Robert-Knutson/Treadmill/ReadMe.md

<!-- Improved compatibility of back to top link: See: https://github.com/othneildrew/Best-README-Template/pull/73 -->

<!--
*** Thanks for checking out the Best-README-Template. If you have a suggestion
*** that would make this better, please fork the repo and create a pull request
*** or simply open an issue with the tag "enhancement".
*** Don't forget to give the project a star!
*** Thanks again! Now go create something AMAZING! :D
-->

<!-- PROJECT SHIELDS -->
<!--
*** I'm using markdown "reference style" links for readability.
*** Reference links are enclosed in brackets [ ] instead of parentheses ( ).
*** See the bottom of this document for the declaration of the reference variables
*** for contributors-url, forks-url, etc. This is an optional, concise syntax you may use.
*** https://www.markdownguide.org/basic-syntax/#reference-style-links
-->
[][contributors-url]
[][forks-url]
[][stars-url]
[][issues-url]
[][license-url]
[][linkedin-url]

<!-- PROJECT LOGO -->
<br />
<div align="center">
  <a href="https://github.com/Robert-Knutson/Treadmill">
    
  </a>

  <h3 align="center">Software for the Portable Purterbation Treadmill</h3>

  <p align="center">
    This repository contains all the programs I created for the treadmill.
    <br />
    <a href="https://github.com/Robert-Knutson/Treadmill"><strong>Explore the docs »</strong></a>
    <br />
    <br />
    <a href="https://github.com/Robert-Knutson/Treadmill">View Demo</a>
    ·
    <a href="https://github.com/Robert-Knutson/Treadmill">Report Bug</a>
    ·
    <a href="https://github.com/Robert-Knutson/Treadmill">Request Feature</a>
  </p>
</div>

<!-- TABLE OF CONTENTS -->
<details>
  <summary>Table of Contents</summary>
  <ol>
    <li>
      <a href="#about-the-project">About The Project</a>
      <ul>
        <li><a href="#built-with">Built With</a></li>
      </ul>
    </li>
    <li>
      <a href="#getting-started">Getting Started</a>
      <ul>
        <li><a href="#prerequisites">Prerequisites</a></li>
        <li><a href="#installation">Installation</a></li>
      </ul>
    </li>
    <li><a href="#usage">Usage</a></li>
    <li><a href="#roadmap">Roadmap</a></li>
    <li><a href="#contributing">Contributing</a></li>
    <li><a href="#license">License</a></li>
    <li><a href="#contact">Contact</a></li>
    <li><a href="#acknowledgments">Acknowledgments</a></li>
  </ol>
</details>

<!-- ABOUT THE PROJECT -->
## About The Project

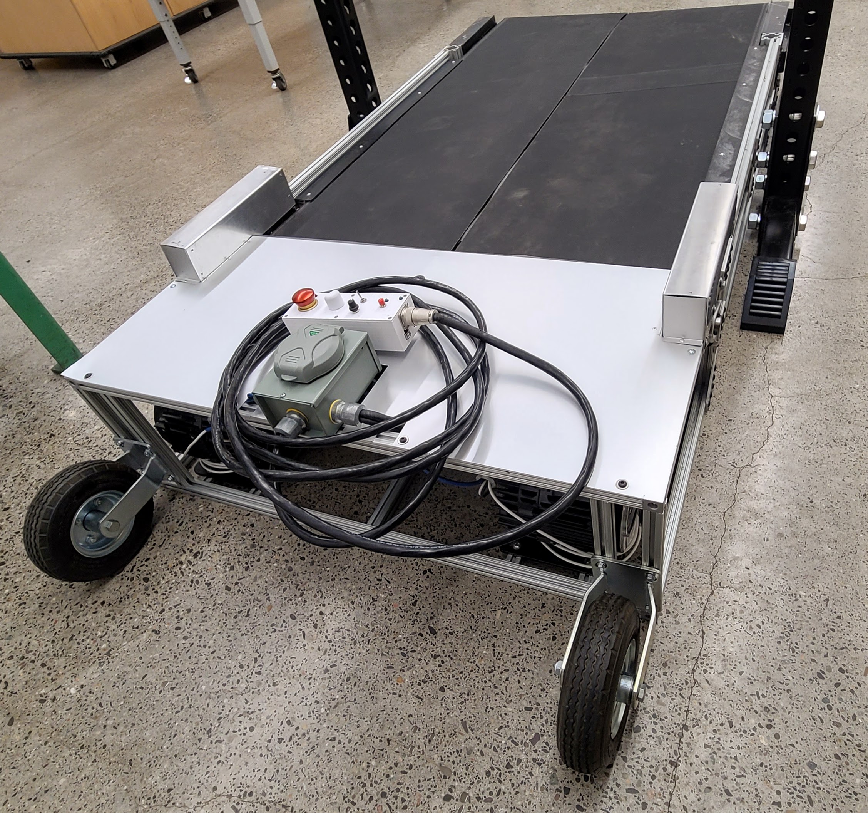
[picture p1: Images/TreadmilPicture.jpg]
[]

The goal of this project was to was to design, fabricate, and validate a mobile perturbation treadmill for balance recovery research.

A folder containing, all the pictures, calculation software, and cad files, can be found here:
https://drive.google.com/drive/folders/1DKQCvQDukhAqRwlkpNQLH-X5j2HSn_FG?usp=sharing

Perturbation Training is an emerging field of study that has been shown to reduce injury rates associated with trips and falls in elderly adults.  In a typical training session, the user stands or walks on a treadmill and is subject to sudden, unexpected acceleration, simulating a slip or trip in a laboratory-controlled environment.  The goal of this training is to improve the user’s ability to maintain and recover balance in situations that can often lead to falls.

  Traditionally, treadmills used for this are large, instrumented devices, that are rigidly bolted to the floor.  This presents a problem for elderly patients with limited mobility and a lack of nearby facilities.  A portable treadmill would be able to serve a larger portion of the at-risk population than current methods have allowed.  We developed a portable perturbation treadmill, capable of high-intensity perturbations.  The final design features a tandem belt configuration, individual belt control, and a minimal gap between the belts.  Each side of the system is fully redundant, each belt is capable of handling 100% of the load.  The belt speed is dictated by a custom human-machine interface and software suite, which allows operators with little programming experience to control the device.  The design has been fully validated and it will be used in multiple locations in an upcoming field test. 

<p align="right">(<a href="#readme-top">back to top</a>)</p>

### Built With

Here is a list of the some of the software that I used for this project.

* <p><a href="https://www.mathworks.com/products/matlab.html">Matlab Logo.png</a><br>
* [][Cpp-url]
* 
* <p><a href="https://www.arduino.cc/">Arduino Lofo.png</a><br>

<p align="right">(<a href="#readme-top">back to top</a>)</p>

<!-- GETTING STARTED -->
## Getting Started

This section will detial how to get the software downloaded and running on your machine.

### Prerequisites

This software was desigined for:
* MATLAB R21A
* SolidWorks 2020
* Ardiino IDE 1.8.13

### Installation

Download the source code for the entire project by clicking on the green code button in the main project folder.  This will download all files used in this project.
Alternatively, go to a specific file you are interested in and click the copy raw contents button which can then be pasted into a blank MATLAB sketch.

<p align="center">
  <kbd>
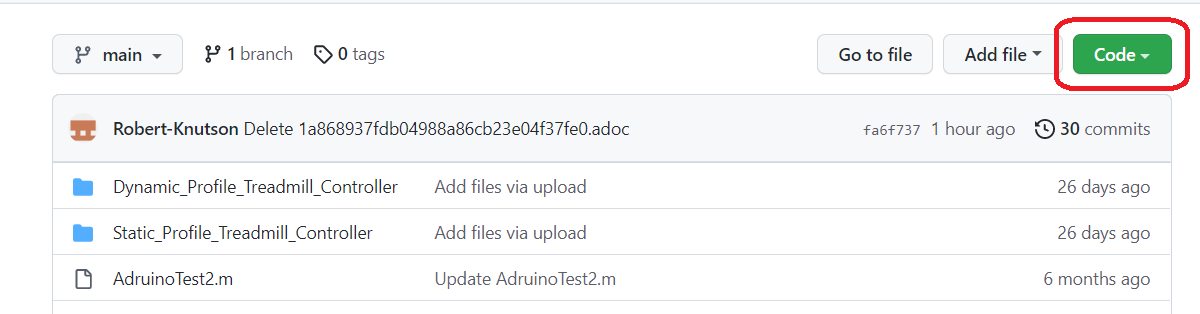
[picture p2: Drag & Drop Profile Generator/Images/media/image1.png]
    
  </kbd>
</p>

<p align="center">
  <kbd>
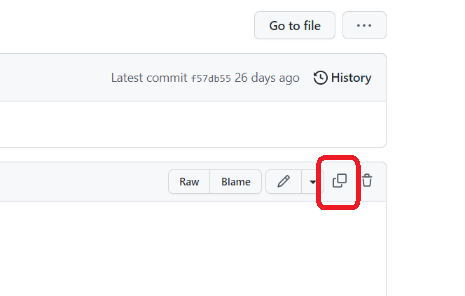
[picture p3: Drag & Drop Profile Generator/Images/media/image2.png]
    
  </kbd>
</p>

<!-- USAGE EXAMPLES -->
## Usage

Profiles can be created using the Drag & Drop Profile Generator, see that folder for more information. 

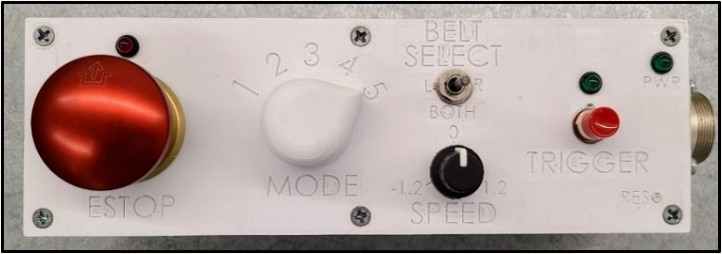
[picture p4: Images/Treadmill HMI.jpg]
[]

Simple operation of the PPT by an individual with no coding experience is facilitated via the HMI. A five-position rotary switch dictates the desired perturbation intensity from predefined values. A center detent potentiometer controls the steady-state walking speed for walking perturbations and provides tactile feedback when the belt speed is set to zero. A three-position switch determines which belt will be active (left, right, or both). A pushbutton switch initiates the perturbation, providing tactile and auditory feedback when engaged. A green trigger status Light Emitting Diode (LED) indicates when a perturbation is being performed. A large Emergency Stop button shuts down the treadmill in case of an emergency with a red LED to indicate activation. A green LED on the right indicates when the system is active and awaiting operator input. All LEDs blink in unison if the software detects a dangerous situation, such as when the belt speed is at a non-zero value on initial power-up or when the Emergency Stop is disengaged. The treadmill is controlled with an Arduino Mega 2560 microcontroller (Arduino, Somerville, MA, USA), which monitors HMI button states and regulates motor speed via Pulse Width Modulated (PWM) signals

_For more examples, please refer to the [Documentation](https://example.com)_

<p align="right">(<a href="#readme-top">back to top</a>)</p>

<!-- ROADMAP -->
## Roadmap

- [x] Add Changelog
- [x] Add back to top links
- [ ] Add Additional Templates w/ Examples
- [ ] Add "components" document to easily copy & paste sections of the readme
- [ ] Multi-language Support
    - [ ] Chinese
    - [ ] Spanish

See the [open issues](https://github.com/othneildrew/Best-README-Template/issues) for a full list of proposed features (and known issues).

<p align="right">(<a href="#readme-top">back to top</a>)</p>

<!-- CONTRIBUTING -->
## Contributing

Contributions are what make the open source community such an amazing place to learn, inspire, and create. Any contributions you make are **greatly appreciated**.

If you have a suggestion that would make this better, please fork the repo and create a pull request. You can also simply open an issue with the tag "enhancement".
Don't forget to give the project a star! Thanks again!

1. Fork the Project
2. Create your Feature Branch (`git checkout -b feature/AmazingFeature`)
3. Commit your Changes (`git commit -m 'Add some AmazingFeature'`)
4. Push to the Branch (`git push origin feature/AmazingFeature`)
5. Open a Pull Request

Or contact me on my Arduino prfile https://id.arduino.cc/anion7

<p align="right">(<a href="#readme-top">back to top</a>)</p>

<!-- LICENSE -->
## License

Distributed under the MIT License. See `LICENSE.txt` for more information.

<p align="right">(<a href="#readme-top">back to top</a>)</p>

<!-- CONTACT -->
## Contact

Have any questions?  Contact me!

Email: anion7.rk@gmail.com 

Project Link: [https://github.com/Robert-Knutson/Treadmill/](https://github.com/Robert-Knutson/Treadmill/)

<p align="right">(<a href="#readme-top">back to top</a>)</p>

<!-- ACKNOWLEDGMENTS -->
## Acknowledgments

Use this space to list resources you find helpful and would like to give credit to. I've included a few of my favorites to kick things off!

* [Choose an Open Source License](https://choosealicense.com)
* [GitHub Emoji Cheat Sheet](https://www.webpagefx.com/tools/emoji-cheat-sheet)
* [Malven's Flexbox Cheatsheet](https://flexbox.malven.co/)
* [Malven's Grid Cheatsheet](https://grid.malven.co/)
* [Img Shields](https://shields.io)
* [GitHub Pages](https://pages.github.com)
* [Font Awesome](https://fontawesome.com)
* [React Icons](https://react-icons.github.io/react-icons/search)

<p align="right">(<a href="#readme-top">back to top</a>)</p>

<!-- MARKDOWN LINKS & IMAGES -->
<!-- https://www.markdownguide.org/basic-syntax/#reference-style-links -->
[contributors-shield]: https://img.shields.io/github/contributors/Robert-Knutson/Treadmill.svg?style=for-the-badge
[contributors-url]: https://github.com/Robert-Knutson/Treadmill/graphs/contributors
[forks-shield]: https://img.shields.io/github/forks/Robert-Knutson/Treadmill.svg?style=for-the-badge
[forks-url]: https://github.com/Robert-Knutson/Treadmill/network/members
[stars-shield]: https://img.shields.io/github/stars/Robert-Knutson/Treadmill.svg?style=for-the-badge
[stars-url]: https://github.com/Robert-Knutson/Treadmill/stargazers
[issues-shield]: https://img.shields.io/github/issues/Robert-Knutson/Treadmill.svg?style=for-the-badge
[issues-url]: https://github.com/Robert-Knutson/Treadmill/issues
[license-shield]: https://img.shields.io/github/license/Robert-Knutson/Treadmill.svg?style=for-the-badge
[license-url]: https://github.com/Robert-Knutson/Treadmill/blob/main/LICENSE.txt
[linkedin-shield]: https://img.shields.io/badge/-LinkedIn-black.svg?style=for-the-badge&logo=linkedin&colorB=555
[linkedin-url]: https://linkedin.com/in/robert-knutson-13254a112/
[product-screenshot]: https://github.com/Robert-Knutson/Treadmill/blob/main/Images/TreadmilPicture.jpg
[hmi-picture]: https://github.com/Robert-Knutson/Treadmill/blob/main/Images/Treadmill%20HMI.jpg

[Cpp-shield]: https://img.shields.io/badge/C++-Solutions-blue.svg?style=flat&logo=c%2B%2B
[Cpp-url]: https://vuejs.org/
[Angular.io]: https://img.shields.io/badge/Angular-DD0031?style=for-the-badge&logo=angular&logoColor=white
[Angular-url]: https://angular.io/
[Svelte.dev]: https://img.shields.io/badge/Svelte-4A4A55?style=for-the-badge&logo=svelte&logoColor=FF3E00
[Svelte-url]: https://svelte.dev/
[Laravel.com]: https://img.shields.io/badge/Laravel-FF2D20?style=for-the-badge&logo=laravel&logoColor=white
[Laravel-url]: https://laravel.com
[Bootstrap.com]: https://img.shields.io/badge/Bootstrap-563D7C?style=for-the-badge&logo=bootstrap&logoColor=white
[Bootstrap-url]: https://getbootstrap.com
[JQuery.com]: https://img.shields.io/badge/jQuery-0769AD?style=for-the-badge&logo=jquery&logoColor=white
[JQuery-url]: https://jquery.com
