Robert-Knutson/Treadmill/Budget - Modified.xlsx

Sheet: Purchase Sheet
Material Costs
Subsystem | Item | Description | Source | MFG Part No. | Cost per unit | Qty Needed | Total Cost | URL
Power Transmission | Motor | Electric motor to drive treadmill belt | Teknic | CPM-MCVC-N0563P-RLN | $784.00 | 2 | $1568.00 | https://www.teknic.com/model-info/CPM-MCVC-N0563P-RLN/
 | Motor Foot | Mounting Bracket for motor | Teknic | FOOT-56-14X | $14.00 | 2 | $28.00 | https://www.teknic.com/clearpath-accessories-guide/accessories-guide-mc-ac/#mounting
 | Driving Pulley | Pulley for motor | RoyalSupply | 7718-1140 | $67.59 | 2 | $135.18 | https://www.royalsupply.com/store/pc/Gates-8MX-25S-12-Poly-Chain-GT2-Sprocket-2-506-Inch-Diameter-7718-1025-p41546.htm
 | Driving Pulley Bushing | Attaches Driving pulley to Motor Shaft | RoyalSupply | 7858-0110 | $13.35 | 2 | $26.70 | https://www.royalsupply.com/store/pc/Gates-1108-5-8-1108-TL-Bushing-5-8-quot-Bore-7858-0110-p67626.htm
 | Driven Pulley | Pulley for Belt Drive Axle | RoyalSupply | 7718-1025 | $287.33 | 2 | $574.66 | https://www.royalsupply.com/store/pc/Gates-8MX-140S-12-Poly-Chain-GT2-Sprocket-14-036-Inch-Diameter-7718-1140-p41577.htm
 | Driven Pulley Bushing | Attaches Driven Pulley to Belt Drive Axle | RoyalSupply | 7858-2612 | $21.17 | 2 | $42.34 | https://www.royalsupply.com/store/pc/Gates-2012-1-3-4-2012-TL-Bushing-1-3-4-quot-Bore-7858-2612-p67720.htm
 | Drive Belt | Transmits power from motor to Front Treadmill Roller | RoyalSupply | 9274-0160 | $43.87 | 2 | $87.74 | https://www.royalsupply.com/store/pc/Gates-8MGT-1440-12-Poly-Chain-GT-Carbon-Synchronous-Belt-9274-0180-p16560.htm
 | Treadmmill Belt | Working Sufrace of Treadmill | WalkingBelts |  | $159.99 | 2 | $319.98 | https://walkingbelts.com/
 | Front Treadmill Belt Drum | Transmits power from Driven Pulley to Treadmill Belt | Applied | XPU0620PXT20 | $157.47 | 4 | $629.88 | https://www.applied.com/c-brands/c-precision-pulley-idler/xpu0620pxt20/Conveyor-Pulley/p/101426682
 |  |  |  |  |  | SubTotal | $3412.48
Frame | Bearings - Center | Mechanical Support for Treadmill Rollers | Grainger | 5RYN6 | $83.58 | 4 | $334.32 | https://www.grainger.com/product/NTN-4-Bolt-Flange-Bearing-with-5RYN6
 | Bolts for Front Outer Bearings | 1/4-20 1" Long, only sold in 100pk on mcmaster, needs T Nut | ACE |  | TBD
 | Washers for Front Outer Bearings | Oversize Washer for 1/4" Bolt, 10pk, | McMaster-Carr |  | $6.06 | 1 | $6.06 | https://www.mcmaster.com/92140A112/
 | Bearing - Outer |  | McMaster-Carr |  | $39.74 | 4 | $158.96 | https://www.mcmaster.com/6494K14/
 | Bolts for Rear - Outer Bearings | 1/2-20 1" Long, 10pk | McMaster-Carr |  | $5.87 | 1 | $5.87 | https://www.mcmaster.com/92865A352/
 | Nuts for Rear - Outer Bearing | 1/2-20, Only sold in 100pk on mcmaster | ACE |  | TBD | 4
 | Bolts for Center bearings | 3/8-16 2" Long, Onlys sold in 50pk on mcmaster | ACE |  | TBD | 8
 | Nuts for Center Bearings | 3/8-16, Only sold in 100pk on mcmaster | ACE |  | TBD | 8
 | Axles | Transmits load from from pulley to bearings, 1045 steel CD | Allmetalsinc |  | $61.58 | 4 | $246.32 | https://allmetalsinc.com/cr1750g.html
 | 1" T-Slot Extrusions | Structural Element - 6105 T5 Aluminum - 8 ft sections | McMaster-Carr |  | $23.57 | 7 | $164.99 | https://www.mcmaster.com/47065T101-47065T123/
 | Double 1" T-Slot Extrusions | Structural Element - 6105 T5 Aluminum - 4 ft sections | McMaster-Carr |  | $20.54 | 5 | $102.70 | https://www.mcmaster.com/47065T107-47065T124/
 | Track Roller | Guides the belt on the top surface |  |  | $18.57 | 14 | $259.98 | https://www.mcmaster.com/3668K23/
 | Wood Nuts for Track Roller | 8-32 3/4" long, 25pk | McMaster-Carr |  | $10.62 | 1 | $10.62 | https://www.mcmaster.com/92105A002/
 | Outer Belt tensioner | Tesnions belt on outer sides | Grainger |  | $206.04 | 2 | $412.08 | https://www.grainger.com/product/33UK93?gucid=N:N:FPL:Free:GGL:CSM-1946:tew63h3:20501231
 | Bolts for Outer Tensioner | 5/8-11 1" Long, 10pk | McMaster-Carr |  | $7.28 | 1 | $7.28 | https://www.mcmaster.com/92865A794/
 | Nuts for Outer Tensioner Bolts | 5/8"-11, 25pk | McMaster-Carr |  | $8.51 | 1 | $8.51 | https://www.mcmaster.com/95462A533/
 | Inner Belt Tensioner | Tensions belt in middle | Grainger |  | $293.76 | 1 | $293.76 | https://www.grainger.com/product/TELESCOPER-Conveyor-Belt-Tensioner-33UK97
 | Center Support Bracket | 90 deg T bracket for single rail, Mounting Fasteners included | McMaster-Carr |  | $7.95 | 8 | $63.60 | https://www.mcmaster.com/47065T278/
 | 90 deg Deck Support Bracket | Attached deck to Center Middle Frame | McMaster-Carr |  | $0.73 | 16 | $11.68 | https://www.mcmaster.com/15275A51/
 | Screws for Deck Support Bracket | #8 0.75" Fiberboard Screw, Attaches barcket to Deck, Only in 100pk on mcmaster | ACE |  | TBD
 | Bolts for Deck Support Bracket | #8-32 1/2" Long, Only in 100pk on mcmaster | ACE |  | TBD
 | Nuts For Decu Support Bracket | #8-32, only sold in 100pk on mcmaster | ACE |  | TBD
 | T Slot 90 Deg Surface Bracket |  | McMaster-Carr |  | $7.92 | 12 | $95.04 | https://www.mcmaster.com/47065T267/
 | 2 Slot Straight Bracket | Mounting Fasteners included | McMaster-Carr |  | $9.26 | 8 | $74.08 | https://www.mcmaster.com/47065T262/
 | T Slot 3 Way Outsude Connector | Connects T Slot meeting at 3 right angles Fasteners Included | McMaster-Carr |  | $10.65 | 4 | $42.60 | https://www.mcmaster.com/47065T244/
 | T Slot Connector Screw | Attaches to threaded hole in center of T Slot | McMaster-Carr |  | $1.79 |  | $0.00 | https://www.mcmaster.com/47065T155/
 | Flat Deck Support Bracket | Attaches Deck to Frame | McMaster-Carr |  | $0.92 | 14 | $12.88 | https://www.mcmaster.com/1394A23/
 | Screws for Flat Deck Support Bracket | #5 5/8" Screws for Fiberboard, 100 PK | McMaster-Carr |  | $8.70 | 1 | $8.70 | https://www.mcmaster.com/97196A103/
 | T Slot Nuts | Attaches items to T Slot Channels | McMaster-Carr |  | $0.55 | 12 | $6.60 | https://www.mcmaster.com/5537T71/
 | Cover - Center | Protects Track Rollers from being stepped on | Grainger |  | $3.95 | 1 | $3.95 | https://www.grainger.com/product/GRAINGER-APPROVED-Aluminum-Flat-Bar-Stock-2EYX2
 | Screws for Cover Center | 8-32 x 1.5" flat head screw, attaches cover to deck, 100pk | McMaster-Carr |  | $8.10 | 1 | $8.10 | https://www.mcmaster.com/90273A203/
 | Nylock Nuts | Low Profile Nylock Nuts 8-32, 100pk | McMaster-Carr |  | $3.23 | 1 | $3.23 | https://www.mcmaster.com/90633A009/
 | Cover - Side | Protects Track Pollers on Left and Right Sides, Wood, 0.75x0.75x38.5, use same material as deck |  |  | $0.00 | 0 | $0.00
 | Fiberboard Screws for Side Cover | #8 1.5" Screws for fiberboard | McMaster-Carr |  | $9.20 | 1 | $9.20 | https://www.mcmaster.com/97196A116/
 | Button Head Screws for Side Cover | 1/4-20 5/16" Screws for T Slot, 25 pk | McMaster-Carr |  | $8.84 | 1 | $8.84 | https://www.mcmaster.com/91255A522/
 | T Slot Nuts | 1/4-20 Nut for attaching items to T Slots, 25 pk | McMaster-Carr |  | $5.44 | 2 | $10.88 | https://www.mcmaster.com/47065T905/
 | Cover Front - Top | Main Section - Annodized Aluminum 48" x 24" | OnlineMetals |  | $41.23 | 1 | $41.23 | https://www.onlinemetals.com/en/buy/anodized-aiuminum/0-04-anodized-aluminum-sheet-clear-5005-aq/pid/23889
 |  | Pulley Covers - Annodized Aluminum 24" x 12" | OnlineMetals |  | $13.42 | 2 | $26.84 | https://www.onlinemetals.com/en/buy/anodized-aiuminum/0-04-anodized-aluminum-sheet-clear-5005-aq/pid/23889
 | Cover Center | Attaches to Electrical Enclosure - USE LEFTOVER FROM FRONT | OnlineMetals |  | $0.00 | 0 | $0.00
 | Frame Middle Structural | 0.25" Steel A36 HR, 8" x 72" | OnlineMetals |  | $91.27 | 1 | $91.27 | https://www.onlinemetals.com/en/buy/hot-roll-steel/0-25-mild-steel-plate-a36-hot-rolled/pid/9610
 | Rear Center Takeup Bracket | 0.25" Steel A36 HR, 6" x 12" USE LEFTOVER FORM MIDDLE | OnlineMetals |  | $0.00 | 0 | $0.00
 | Belt Tensioner Bracket | 0.25" Steel A36 HR, 12" x 15" | OnlineMetals |  | $40.45 | 2 | $80.90 | https://www.onlinemetals.com/en/buy/hot-roll-steel/0-25-mild-steel-plate-a36-hot-rolled/pid/9610
 | Bolts for Belt Tensioner Bracket | 1/4-20 0.5" Long, Only sold in 100pk on mcmaster, needs T Nut | ACE |  | TBD | 4
 | Bolts for Motor Moounts | 1/4-20 0.5" Long, Only sold in 100pk on mcmaster, needs T Nut | ACE |  |  | 8
 | Wheels |  |  |  |  |  | $0.00
 | Deck | 3/4" MDF, 4' x 8' Sheet | HomeDepot |  | $41.47 | 1 | $41.47 | https://www.homedepot.com/p/3-4-in-x-4-ft-x-8-ft-MDF-Panel-D11612490970000/304325742
 | Deck Top Surfacce | Provides slippery sufrace, prevents wear to deck | McMaster-Carr |  | $50.76 | 3 | $152.28 | https://www.mcmaster.com/85705K27/
 |  |  |  |  |  | SubTotal | $2804.82
Electronics | 240V 50A Power Cord | Check terminal types on generator | Amazon |  | $279.99 | 1 | $279.99 | https://www.amazon.com/Conntek-1450SS2-50-Temporary-Generator-Straight-Blade/dp/B004NYAXLU
 | Arduino Mega 2560 | Microcontroller | ArduinoStore |  | $40.30 | 1 | $40.30 | https://store.arduino.cc/usa/mega-2560-r3
 | Arduino data logger | SD Card Sheid for Arduino | Adafruit |  | $13.95 | 1 | $13.95 | https://www.adafruit.com/product/1141
 | SD Card | 8 GB, Micro SD but comes with adapter | Adafruit |  | $9.95 | 1 | $9.95 | https://www.adafruit.com/product/1294
 | USB Cord | 10 ft USB A to B | Teknic |  | $9.00 | 1 | $9.00 | https://www.teknic.com/CPM-CABLE-USB-120AB/
 | Power Adapter | 9 V, 1.5 A, 6 ft cord | Amazon |  | $8.99 | 1 | $8.99 | https://www.amazon.com/Adapter-Arduino-Schwinn-Elliptical-Recumbent/dp/B06Y1LF8T5
 | Status LEDs | 5 mm, already owned |  |  | $0.00 | 0 | $0.00
 | E Stop Button | Large button to send stop comand to motor | Automation Direct |  | $36.00 | 1 | $36.00 | https://www.automationdirect.com/adc/shopping/catalog/pushbuttons_-z-_switches_-z-_indicators/schmersal_30mm/emergency_stop_-a-_mushroom_pushbuttons/edrz40.vhrt
 | E Stop Button Contacts | (1) N.O./(1) N.C. Position 1 | Automation Direct |  | $9.75 | 1 | $9.75 | https://www.automationdirect.com/adc/shopping/catalog/pushbuttons_-z-_switches_-z-_indicators/schmersal_22mm_harsh_duty,_ip69k_rated_devices/22mm_pushbutton_a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
 |  | (1) N.O./(1) N.C. Position 2 | Automation Direct |  | $9.75 | 1 | $9.75 | https://www.automationdirect.com/adc/shopping/catalog/pushbuttons_-z-_switches_-z-_indicators/schmersal_22mm_harsh_duty,_ip69k_rated_devices/22mm_pushbutton_a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
 |  | (1) N.O./(1) N.C. Position 3 | Automation Direct |  | $9.75 | 1 | $9.75 | https://www.automationdirect.com/adc/shopping/catalog/pushbuttons_-z-_switches_-z-_indicators/schmersal_22mm_harsh_duty,_ip69k_rated_devices/22mm_pushbutton_a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
 | Case for Arduino and E Stop | Going to 3D print |  |  | $0.00 | 0 | $0.00
 | Data Cable To Treadmill | 22 GA by 10 ft | Teknic |  | $23.00 | 2 | $46.00 | https://www.teknic.com/CPM-CABLE-CTRL-MU120/
 | 240 V Electrical Plug & Encolosure |  | Amazon |  | $33.38 | 1 | $33.38 | https://www.amazon.com/Talon-LGP1S-Enclosed-Outdoor-Receptacle/dp/B00M3H6494
 | 12 GA Wires for Motor Power | 3 Wire TPE Overmold, only ships in 20' increments, 0.435" OD | Automation Direct |  | $17.20 | 1 | $17.20 | https://www.automationdirect.com/adc/shopping/catalog/cables/bulk_multi-conductor_cable/flexible_portable_cord_(sjoow,_soow,_sjeoow,_seoow,_type_w)/insulation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
 | Strain Releif for Motor Power |  | Grainger |  | $6.14 | 2 | $12.28 | https://www.grainger.com/product/ARLINGTON-Liquid-Tight-Cord-Connector-4JWP2
 |  |  |  |  |  | Subtotal | $536.29
Extras | Generator | Auxillary power ,12000 W Continuous | DuroMAX | XP13000EH | $1399.00 | 1 | $1399.00 | https://www.homedepot.com/p/DUROMAX-13000-10500-Watt-Push-Start-Heavy-Duty-Dual-Fuel-Powered-Portable-Generator-Transfer-Switch-and-Home-Backup-Ready-XP13000E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
 | Gorilla Wood Glue | Keeps woodnuts from pulling out | HomeDepot |  | $7.99 | 1 | $7.99
 | Red Loctite |  | HomeDepot |  | $4.99 | 1 | $4.99
 |  |  |  |  |  | Subtotal | $1411.98
 |  |  |  |  |  | Overall Total | $8165.57

Sheet: Consolidated Vendors
Vendor List
ACE | $0.00 | Total | #REF!
Adafruit | $23.90
Allmetalsinc | $246.32
Amazon | $322.36
Applied | $629.88
ArduinoStore | $40.30
Automation Direct | $82.45
DuroMAX | #REF!
Grainger | $1056.39
HomeDepot | $54.45
McMaster-Carr | $972.70
OnlineMetals | $240.24
RoyalSupply | $866.62
Teknic | $1651.00
WalkingBelts | $319.98

Sheet: Applied
Applied | Purchase Sheet
Item | Description | Source | MFG Part No. | Cost per unit | Qty Needed | Total Cost | URL
Front Treadmill Belt Drum | Transmits power from Driven Pulley to Treadmill Belt | Applied | XPU0620PXT20 | $157.47 | 4 | $629.88 | https://www.applied.com/c-brands/c-precision-pulley-idler/xpu0620pxt20/Conveyor-Pulley/p/101426682

Sheet: Amazon
Amazon | Purchase Sheet
Item | Description | Source | MFG Part No. | Cost per unit | Qty Needed | Total Cost | URL
240V 50A Power Cord | Check terminal types on generator | Amazon | 0 | $279.99 | 1 | $279.99 | https://www.amazon.com/Conntek-1450SS2-50-Temporary-Generator-Straight-Blade/dp/B004NYAXLU
Power Adapter | 9 V, 1.5 A, 6 ft cord | Amazon | 0 | $8.99 | 1 | $8.99 | https://www.amazon.com/Adapter-Arduino-Schwinn-Elliptical-Recumbent/dp/B06Y1LF8T5
240 V Electrical Plug & Encolosure | 0 | Amazon | 0 | $33.38 | 1 | $33.38 | https://www.amazon.com/Talon-LGP1S-Enclosed-Outdoor-Receptacle/dp/B00M3H6494

Sheet: Allmetalsinc
Allmetalsinc | Purchase Sheet
Item | Description | Source | MFG Part No. | Cost per unit | Qty Needed | Total Cost | URL
Axles | Transmits load from from pulley to bearings, 1045 steel CD | Allmetalsinc | 0 | $61.58 | 4 | $246.32 | https://allmetalsinc.com/cr1750g.html

Sheet: Adafruit
Adafruit | Purchase Sheet
Item | Description | Source | MFG Part No. | Cost per unit | Qty Needed | Total Cost | URL
Arduino data logger | SD Card Sheid for Arduino | Adafruit | 0 | $13.95 | 1 | $13.95 | https://www.adafruit.com/product/1141
SD Card | 8 GB, Micro SD but comes with adapter | Adafruit | 0 | $9.95 | 1 | $9.95 | https://www.adafruit.com/product/1294

Sheet: ArduinoStore
ArduinoStore | Purchase Sheet
Item | Description | Source | MFG Part No. | Cost per unit | Qty Needed | Total Cost | URL
Arduino Mega 2560 | Microcontroller | ArduinoStore | 0 | $40.30 | 1 | $40.30 | https://store.arduino.cc/usa/mega-2560-r3

Sheet: Automation Direct
Automation Direct | Purchase Sheet
Item | Description | Source | MFG Part No. | Cost per unit | Qty Needed | Total Cost | URL
E Stop Button | Large button to send stop comand to motor | Automation Direct | 0 | $36.00 | 1 | $36.00 | https://www.automationdirect.com/adc/shopping/catalog/pushbuttons_-z-_switches_-z-_indicators/schmersal_30mm/emergency_stop_-a-_mushroom_pushbuttons/edrz40.vhrt
E Stop Button Contacts | (1) N.O./(1) N.C. Position 1 | Automation Direct | 0 | $9.75 | 1 | $9.75 | https://www.automationdirect.com/adc/shopping/catalog/pushbuttons_-z-_switches_-z-_indicators/schmersal_22mm_harsh_duty,_ip69k_rated_devices/22mm_pushbutton_a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
0 | (1) N.O./(1) N.C. Position 2 | Automation Direct | 0 | $9.75 | 1 | $9.75 | https://www.automationdirect.com/adc/shopping/catalog/pushbuttons_-z-_switches_-z-_indicators/schmersal_22mm_harsh_duty,_ip69k_rated_devices/22mm_pushbutton_a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
0 | (1) N.O./(1) N.C. Position 3 | Automation Direct | 0 | $9.75 | 1 | $9.75 | https://www.automationdirect.com/adc/shopping/catalog/pushbuttons_-z-_switches_-z-_indicators/schmersal_22mm_harsh_duty,_ip69k_rated_devices/22mm_pushbutton_a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
12 GA Wires for Motor Power | 3 Wire TPE Overmold, only ships in 20' increments, 0.435" OD | Automation Direct | 0 | $17.20 | 1 | $17.20 | https://www.automationdirect.com/adc/shopping/catalog/cables/bulk_multi-conductor_cable/flexible_portable_cord_(sjoow,_soow,_sjeoow,_seoow,_type_w)/insulation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

Sheet: Grainger
Grainger | Purchase Sheet
Item | Description | Source | MFG Part No. | Cost per unit | Qty Needed | Total Cost | URL
Bearings - Center | Mechanical Support for Treadmill Rollers | Grainger | 5RYN6 | $83.58 | 4 | $334.32 | https://www.grainger.com/product/NTN-4-Bolt-Flange-Bearing-with-5RYN6
Outer Belt tensioner | Tesnions belt on outer sides | Grainger | 0 | $206.04 | 2 | $412.08 | https://www.grainger.com/product/33UK93?gucid=N:N:FPL:Free:GGL:CSM-1946:tew63h3:20501231
Inner Belt Tensioner | Tensions belt in middle | Grainger | 0 | $293.76 | 1 | $293.76 | https://www.grainger.com/product/TELESCOPER-Conveyor-Belt-Tensioner-33UK97
Cover - Center | Protects Track Rollers from being stepped on | Grainger | 0 | $3.95 | 1 | $3.95 | https://www.grainger.com/product/GRAINGER-APPROVED-Aluminum-Flat-Bar-Stock-2EYX2
Strain Releif for Motor Power | 0 | Grainger | 0 | $6.14 | 2 | $12.28 | https://www.grainger.com/product/ARLINGTON-Liquid-Tight-Cord-Connector-4JWP2

Sheet: HomeDepot
HomeDepot | Purchase Sheet
Item | Description | Source | MFG Part No. | Cost per unit | Qty Needed | Total Cost | URL
Deck | 3/4" MDF, 4' x 8' Sheet | HomeDepot | 0 | $41.47 | 1 | $41.47 | https://www.homedepot.com/p/3-4-in-x-4-ft-x-8-ft-MDF-Panel-D11612490970000/304325742
Gorilla Wood Glue | Keeps woodnuts from pulling out | HomeDepot | 0 | $7.99 | 1 | $7.99 | 0
Red Loctite | 0 | HomeDepot | 0 | $4.99 | 1 | $4.99 | 0

Sheet: McMaster-Carr
McMaster-Carr | Purchase Sheet
Item | Description | Source | MFG Part No. | Cost per unit | Qty Needed | Total Cost | URL
Washers for Front Outer Bearings | Oversize Washer for 1/4" Bolt, 10pk, | McMaster-Carr | 0 | $6.06 | 1 | $6.06 | https://www.mcmaster.com/92140A112/
Bearing - Outer | 0 | McMaster-Carr | 0 | $39.74 | 4 | $158.96 | https://www.mcmaster.com/6494K14/
Bolts for Rear - Outer Bearings | 1/2-20 1" Long, 10pk | McMaster-Carr | 0 | $5.87 | 1 | $5.87 | https://www.mcmaster.com/92865A352/
1" T-Slot Extrusions | Structural Element - 6105 T5 Aluminum - 8 ft sections | McMaster-Carr | 0 | $23.57 | 7 | $164.99 | https://www.mcmaster.com/47065T101-47065T123/
Double 1" T-Slot Extrusions | Structural Element - 6105 T5 Aluminum - 4 ft sections | McMaster-Carr | 0 | $20.54 | 5 | $102.70 | https://www.mcmaster.com/47065T107-47065T124/
Wood Nuts for Track Roller | 8-32 3/4" long, 25pk | McMaster-Carr | 0 | $10.62 | 1 | $10.62 | https://www.mcmaster.com/92105A002/
Bolts for Outer Tensioner | 5/8-11 1" Long, 10pk | McMaster-Carr | 0 | $7.28 | 1 | $7.28 | https://www.mcmaster.com/92865A794/
Nuts for Outer Tensioner Bolts | 5/8"-11, 25pk | McMaster-Carr | 0 | $8.51 | 1 | $8.51 | https://www.mcmaster.com/95462A533/
Center Support Bracket | 90 deg T bracket for single rail, Mounting Fasteners included | McMaster-Carr | 0 | $7.95 | 8 | $63.60 | https://www.mcmaster.com/47065T278/
90 deg Deck Support Bracket | Attached deck to Center Middle Frame | McMaster-Carr | 0 | $0.73 | 16 | $11.68 | https://www.mcmaster.com/15275A51/
T Slot 90 Deg Surface Bracket | 0 | McMaster-Carr | 0 | $7.92 | 12 | $95.04 | https://www.mcmaster.com/47065T267/
2 Slot Straight Bracket | Mounting Fasteners included | McMaster-Carr | 0 | $9.26 | 8 | $74.08 | https://www.mcmaster.com/47065T262/
T Slot 3 Way Outsude Connector | Connects T Slot meeting at 3 right angles Fasteners Included | McMaster-Carr | 0 | $10.65 | 4 | $42.60 | https://www.mcmaster.com/47065T244/
T Slot Connector Screw | Attaches to threaded hole in center of T Slot | McMaster-Carr | 0 | $1.79 | 0 | $0.00 | https://www.mcmaster.com/47065T155/
Flat Deck Support Bracket | Attaches Deck to Frame | McMaster-Carr | 0 | $0.92 | 14 | $12.88 | https://www.mcmaster.com/1394A23/
Screws for Flat Deck Support Bracket | #5 5/8" Screws for Fiberboard, 100 PK | McMaster-Carr | 0 | $8.70 | 1 | $8.70 | https://www.mcmaster.com/97196A103/
T Slot Nuts | Attaches items to T Slot Channels | McMaster-Carr | 0 | $0.55 | 12 | $6.60 | https://www.mcmaster.com/5537T71/
Screws for Cover Center | 8-32 x 1.5" flat head screw, attaches cover to deck, 100pk | McMaster-Carr | 0 | $8.10 | 1 | $8.10 | https://www.mcmaster.com/90273A203/
Nylock Nuts | Low Profile Nylock Nuts 8-32, 100pk | McMaster-Carr | 0 | 3.23 | 1 | $3.23 | https://www.mcmaster.com/90633A009/
Fiberboard Screws for Side Cover | #8 1.5" Screws for fiberboard | McMaster-Carr | 0 | 9.2 | 1 | $9.20 | https://www.mcmaster.com/97196A116/
Button Head Screws for Side Cover | 1/4-20 5/16" Screws for T Slot, 25 pk | McMaster-Carr | 0 | 8.84 | 1 | $8.84 | https://www.mcmaster.com/91255A522/
T Slot Nuts | 1/4-20 Nut for attaching items to T Slots, 25 pk | McMaster-Carr | 0 | 5.44 | 2 | $10.88 | https://www.mcmaster.com/47065T905/
Deck Top Surfacce | Provides slippery sufrace, prevents wear to deck | McMaster-Carr | 0 | 50.76 | 3 | $152.28 | https://www.mcmaster.com/85705K27/

Sheet: OnlineMetals
OnlineMetals | Purchase Sheet
Item | Description | Source | MFG Part No. | Cost per unit | Qty Needed | Total Cost | URL
Cover Front - Top | Main Section - Annodized Aluminum 48" x 24" | OnlineMetals | 0 | $41.23 | 1 | $41.23 | https://www.onlinemetals.com/en/buy/anodized-aiuminum/0-04-anodized-aluminum-sheet-clear-5005-aq/pid/23889
0 | Pulley Covers - Annodized Aluminum 24" x 12" | OnlineMetals | 0 | $13.42 | 2 | $26.84 | https://www.onlinemetals.com/en/buy/anodized-aiuminum/0-04-anodized-aluminum-sheet-clear-5005-aq/pid/23889
Cover Center | Attaches to Electrical Enclosure - USE LEFTOVER FROM FRONT | OnlineMetals | 0 | $0.00 | 0 | $0.00 | 0
Frame Middle Structural | 0.25" Steel A36 HR, 8" x 72" | OnlineMetals | 0 | $91.27 | 1 | $91.27 | https://www.onlinemetals.com/en/buy/hot-roll-steel/0-25-mild-steel-plate-a36-hot-rolled/pid/9610
Rear Center Takeup Bracket | 0.25" Steel A36 HR, 6" x 12" USE LEFTOVER FORM MIDDLE | OnlineMetals | 0 | $0.00 | 0 | $0.00 | 0
Belt Tensioner Bracket | 0.25" Steel A36 HR, 12" x 15" | OnlineMetals | 0 | $40.45 | 2 | $80.90 | https://www.onlinemetals.com/en/buy/hot-roll-steel/0-25-mild-steel-plate-a36-hot-rolled/pid/9610

Sheet: RoyalSupply
RoyalSupply | Purchase Sheet
Item | Description | Source | MFG Part No. | Cost per unit | Qty Needed | Total Cost | URL
Driving Pulley | Pulley for motor | RoyalSupply | 7718-1140 | $67.59 | 2 | $135.18 | https://www.royalsupply.com/store/pc/Gates-8MX-25S-12-Poly-Chain-GT2-Sprocket-2-506-Inch-Diameter-7718-1025-p41546.htm
Driving Pulley Bushing | Attaches Driving pulley to Motor Shaft | RoyalSupply | 7858-0110 | $13.35 | 2 | $26.70 | https://www.royalsupply.com/store/pc/Gates-1108-5-8-1108-TL-Bushing-5-8-quot-Bore-7858-0110-p67626.htm
Driven Pulley | Pulley for Belt Drive Axle | RoyalSupply | 7718-1025 | $287.33 | 2 | $574.66 | https://www.royalsupply.com/store/pc/Gates-8MX-140S-12-Poly-Chain-GT2-Sprocket-14-036-Inch-Diameter-7718-1140-p41577.htm
Driven Pulley Bushing | Attaches Driven Pulley to Belt Drive Axle | RoyalSupply | 7858-2612 | $21.17 | 2 | $42.34 | https://www.royalsupply.com/store/pc/Gates-2012-1-3-4-2012-TL-Bushing-1-3-4-quot-Bore-7858-2612-p67720.htm
Drive Belt | Transmits power from motor to Front Treadmill Roller | RoyalSupply | 9274-0160 | $43.87 | 2 | $87.74 | https://www.royalsupply.com/store/pc/Gates-8MGT-1440-12-Poly-Chain-GT-Carbon-Synchronous-Belt-9274-0180-p16560.htm

Sheet: usarollerchain
usarollerchain | Purchase Sheet
Item | Description | Source | MFG Part No. | Cost per unit | Qty Needed | Total Cost | URL
No Results

Sheet: WalkingBelts
WalkingBelts | Purchase Sheet
Item | Description | Source | MFG Part No. | Cost per unit | Qty Needed | Total Cost | URL
Treadmmill Belt | Working Sufrace of Treadmill | WalkingBelts | 0 | $159.99 | 2 | $319.98 | https://walkingbelts.com/

Sheet: Teknic
Teknic | Purchase Sheet
Item | Description | Source | MFG Part No. | Cost per unit | Qty Needed | Total Cost | URL
Motor | Electric motor to drive treadmill belt | Teknic | CPM-MCVC-N0563P-RLN | $784.00 | 2 | $1568.00 | https://www.teknic.com/model-info/CPM-MCVC-N0563P-RLN/
Motor Foot | Mounting Bracket for motor | Teknic | FOOT-56-14X | $14.00 | 2 | $28.00 | https://www.teknic.com/clearpath-accessories-guide/accessories-guide-mc-ac/#mounting
USB Cord | 10 ft USB A to B | Teknic | 0 | $9.00 | 1 | $9.00 | https://www.teknic.com/CPM-CABLE-USB-120AB/
Data Cable To Treadmill | 22 GA by 10 ft | Teknic | 0 | $23.00 | 2 | $46.00 | https://www.teknic.com/CPM-CABLE-CTRL-MU120/
