Robert-Knutson/Treadmill/New Items To Buy.xlsx

Items to purchace
 |  | Cost | QTY
 | Controller Box
 | 24 pin female header | $12.82 | 1 | https://www.mouser.com/ProductDetail/Hirose-Connector/JR25RK-24P?qs=XQjbzJWzFPVnrbsm8wajQQ%3D%3D
 | 24 pin mae header | $14.22 | 1 | https://www.mouser.com/ProductDetail/Hirose-Connector/JR25RK-24S?qs=XQjbzJWzFPXA3TCqdHDUaw%3D%3D
 | 3 pos rotary switch SP3T | $5.70 | 1 | https://www.mouser.com/ProductDetail/CK/A11514RNZQ?qs=h7H1bHRqGz%2FZgH40Rbpnqw%3D%3D
 | Total | $32.74
 | Momentary switch | $3.84 | 1 | https://www.digikey.com/en/products/detail/e-switch/800SP9B9M1QEH/1804308
 | 24 pin mae header | $6.86 | 1 | https://www.digikey.com/en/products/detail/jae-electronics/SRCN2A21-16P/1283269
 | 24 pin female header | $12.87 | 1 | https://www.digikey.com/en/products/detail/jae-electronics/SRCN6A21-16S/1283287
 | 3P Rotary Switch | $5.87 | 1 | https://www.digikey.com/en/products/detail/c-k/A10515RNZQ/3751735
15mA | LED indicator Light - Green | $2.09 | 1 | https://www.digikey.com/en/products/detail/dialight/5590202001F/2430873
 | LED indicator Light - Red | $2.09 | 1 | https://www.digikey.com/en/products/detail/dialight/5590102001F/2430866
 | Shipping | $6.99
 | Import Tarrif | $0.38
 | Total | $40.99
 | Panel Mount 10K potentiometer | $0.95 | 1 | https://www.adafruit.com/product/562
 | Slim Metal Potentiometer Knob | $0.95 | 1 | https://www.adafruit.com/product/2058
 | Shipping | $5.45
 | Total | $7.35
 | Panel Mount Center Detent Potentiometers | $1.19 | 1 | https://www.mouser.com/ProductDetail/BI-Technologies-TT-Electronics/P160KNP-1QC20B10K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
 | Potentiometer Knob - Soft Touch T18 - White | $0.50 | 1 | https://www.mouser.com/ProductDetail/Adafruit/2047?qs=GURawfaeGuAxQiyT4g6LnA%3D%3D
 | Toggle Switches SPDT ON-OFF-ON SLDR | $3.09 | 1 | https://www.mouser.com/ProductDetail/?qs=01kh3H%252BlXii4p%252BEtUTMbzg%3D%3D
 | Switch Hardware DRESS NUT | $1.39 | 1 | https://www.mouser.com/ProductDetail/NKK-Switches/AT532TH?qs=Dbnw6jgPYP7mWMTsYfxgbQ%3D%3D
 | Jumper Wires | $13.25 | 2 | https://www.mouser.com/ProductDetail/BusBoard-Prototype-Systems/KIT-ZW-20x3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
 | Heat Shrink Tubing | $9.95 | 1 | https://www.mouser.com/ProductDetail/Adafruit/4559?qs=W%2FMpXkg%252BdQ4uwPI5LkNIcg%3D%3D
 | Shipping | $7.99
 | Total | $37.36
 | nema ss2-50r to nema 5-15p (To use on 120v) | $24.39 | 1 | https://www.amazon.com/dp/B08RBHCNNF
 | Nema 14-50R to Nema L15-30P (Three Phase, for adapting existing extension cord to wall outlet in shop) | $58.99 | 1 | https://www.amazon.com/AC-WORKS-Electric-Vehicle-Charging/dp/B0923JT846?th=1
