Robert-Knutson/Treadmill/MultipleTestsGoodData.jpg

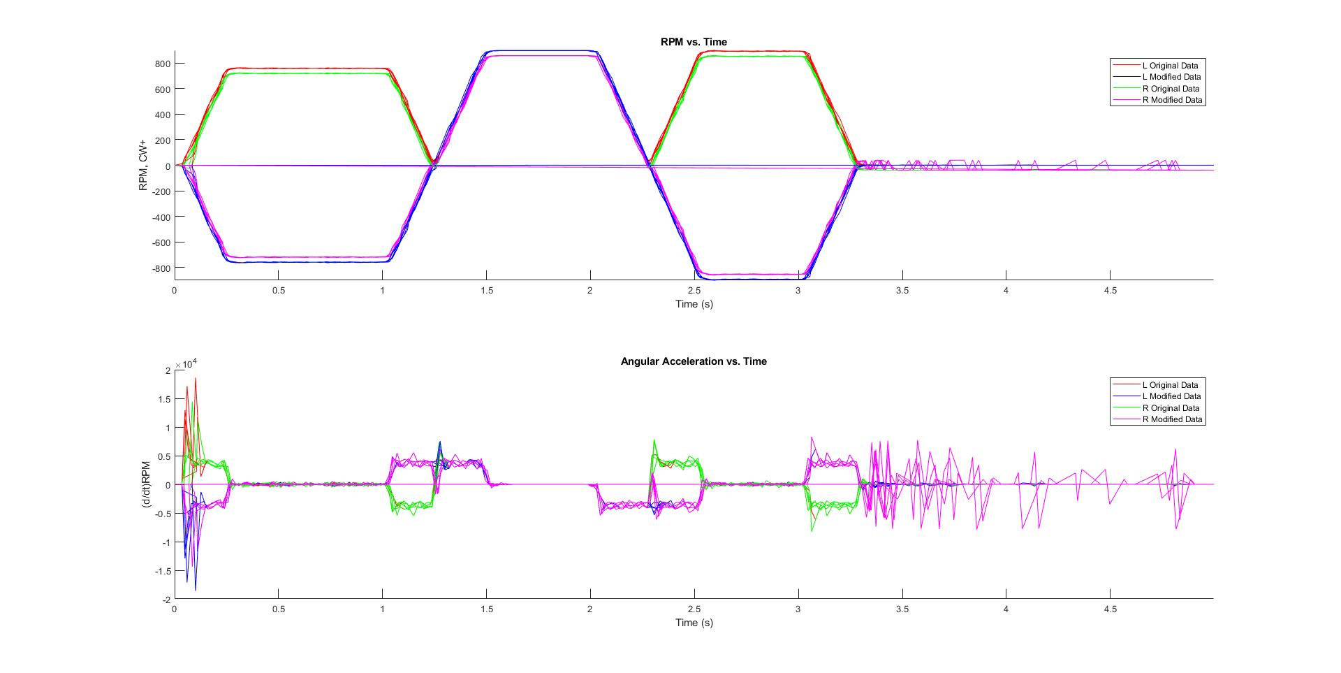
MultipleTestsGoodData.jpg
